jbea035/BulletFeeder/README.md

# BulletFeeder
3D printable bullet collator and feeder design.
