jbea035/BulletFeeder/Bullet Feeder Assembly.SLDASM

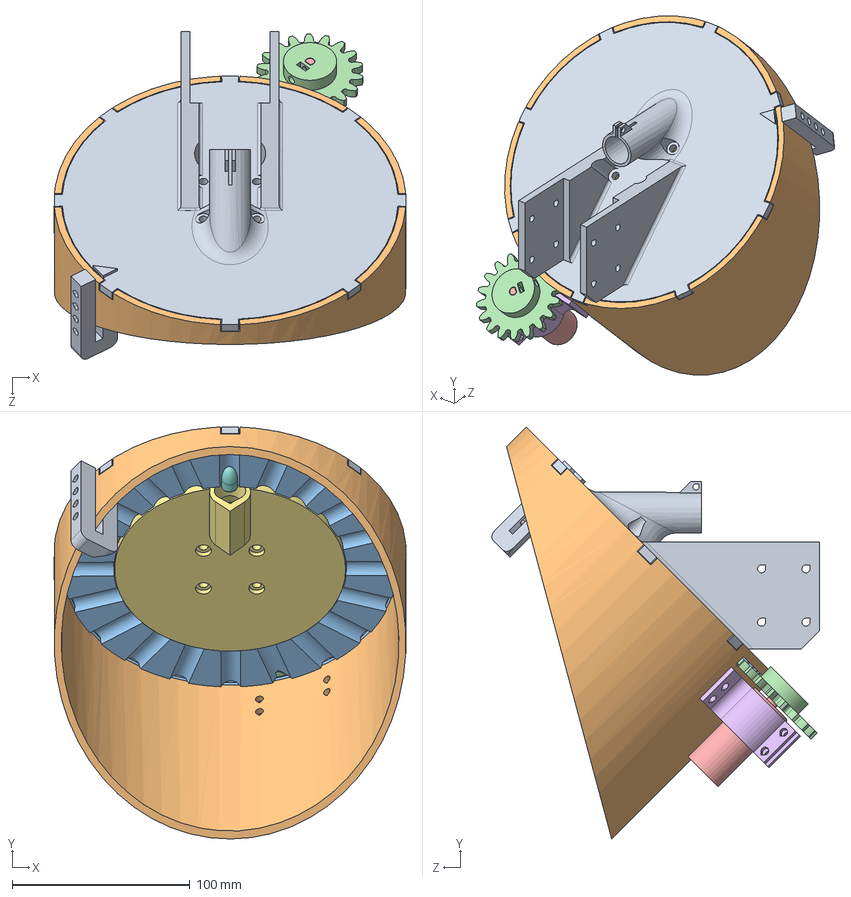
[picture p1: CAD file, 2015-07-16]
Bullet Feeder Assembly.SLDASM
197.9 x 231.8 x 184.3 mm
Bullet Feeder - Bowl Base
Bullet Feeder - Bowl
Bullet Feeder - Platter
Drive Gear
Gearhead Motor
Motor Mount
Bullet Feeder - Center - Bottom Drop
9mm Bullet
Bullet Feeder - 10mm Bullet Wiper
