jbea035/BulletFeeder/Gearhead Motor.SLDPRT

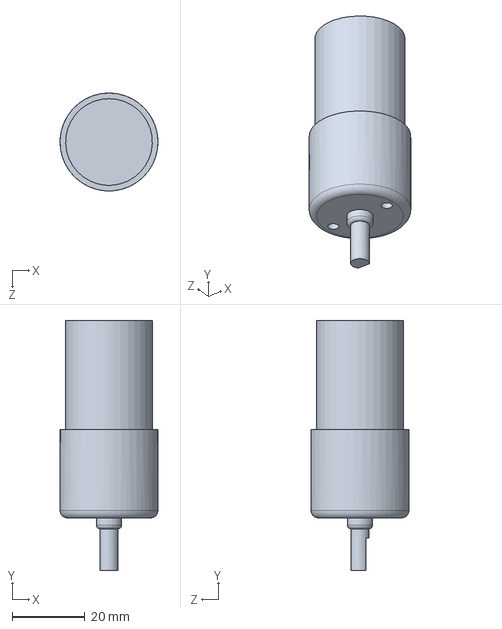
[picture p2: CAD file, 2015-07-16]
Gearhead Motor.SLDPRT
27.0 x 68.9 x 27.0 mm
