jbea035/BulletFeeder/v2 STL/Bullet Feeder - Bowl Base.STL

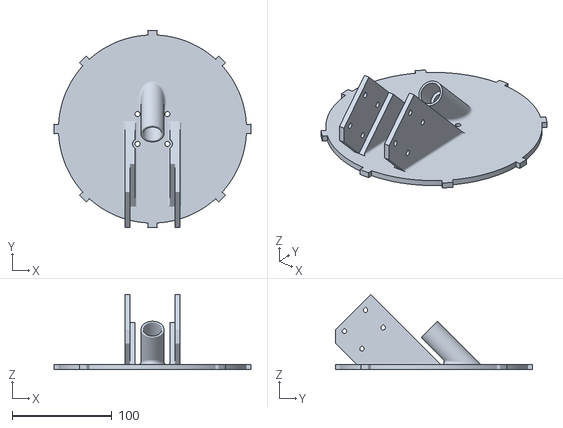
[picture p3: CAD file, 2015-07-16]
v2 STL/Bullet Feeder - Bowl Base.STL
198.0 x 198.0 x 75.7
