jbea035/BulletFeeder/Feed Die Switch Tube .SLDPRT

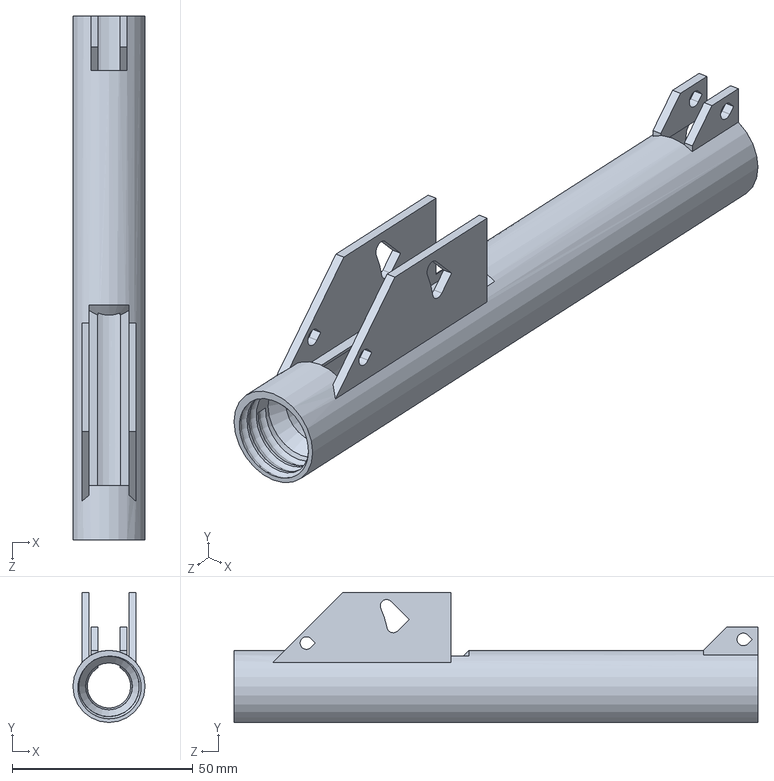
[picture p4: CAD file, 2015-07-16]
Feed Die Switch Tube .SLDPRT
20.0 x 36.0 x 145.0 mm
