jbea035/BulletFeeder/Bullet Feeder - 10mm Bullet Wiper.SLDPRT

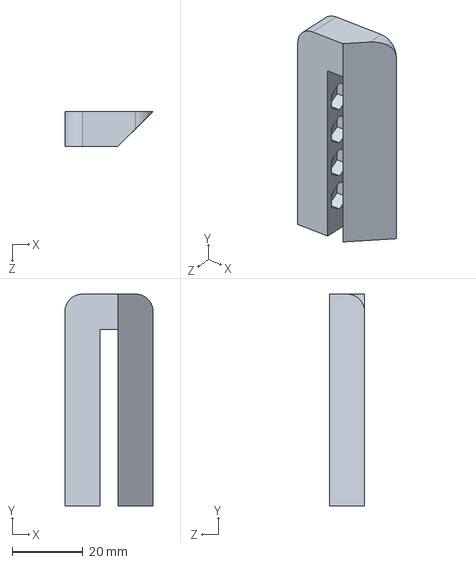
[picture p5: CAD file, 2015-07-16]
Bullet Feeder - 10mm Bullet Wiper.SLDPRT
25.0 x 60.0 x 10.0 mm
