jbea035/BulletFeeder/v2 STL/Bullet Feeder - Bowl.STL

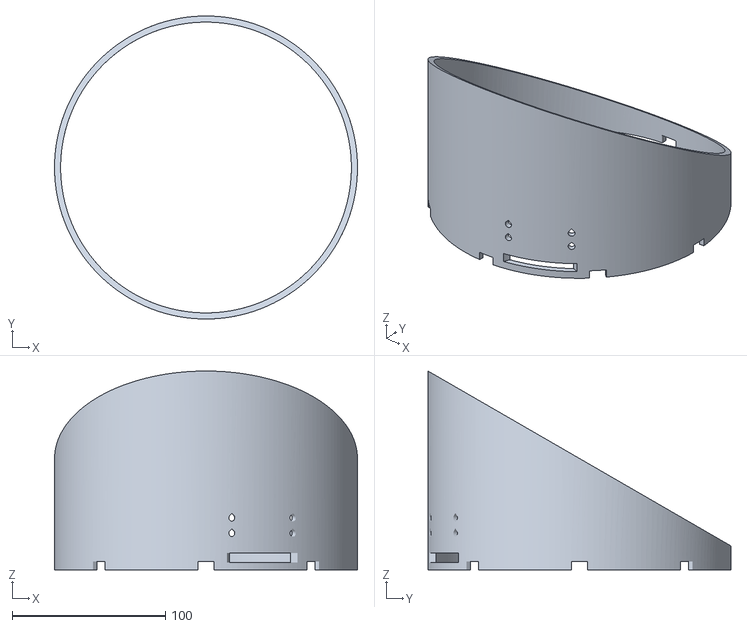
[picture p6: CAD file, 2015-07-16]
v2 STL/Bullet Feeder - Bowl.STL
198.0 x 198.0 x 130.0
