jbea035/BulletFeeder/Bullet Feeder - Platter.SLDPRT

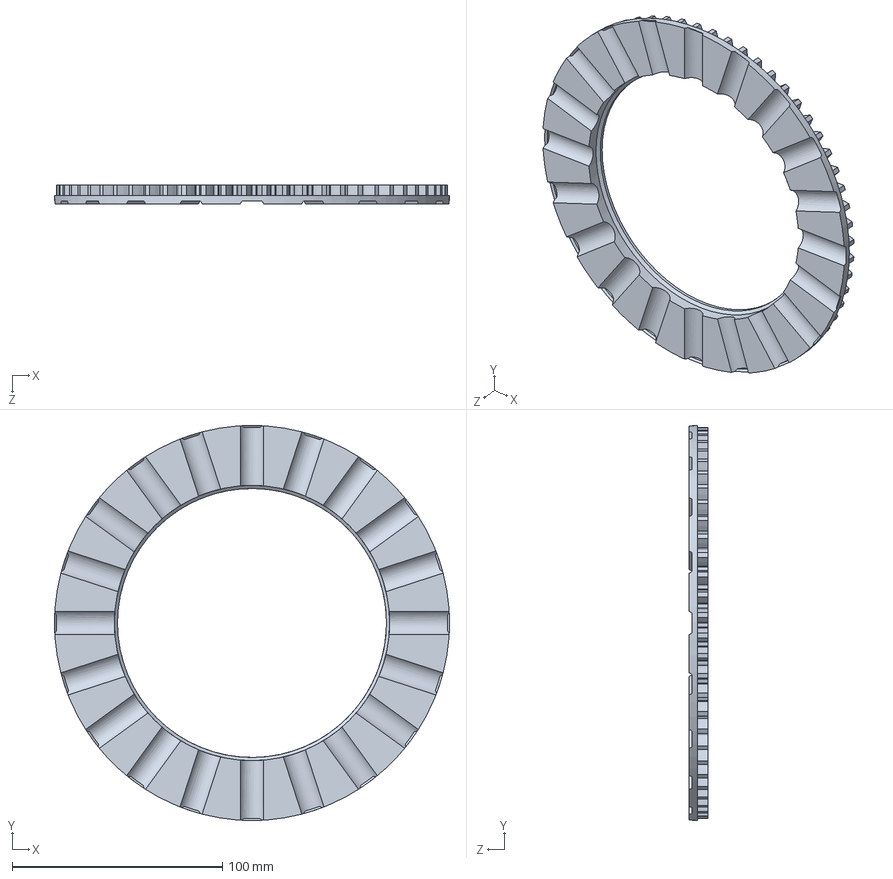
[picture p7: CAD file, 2015-07-16]
Bullet Feeder - Platter.SLDPRT
188.0 x 188.0 x 9.00 mm
