jbea035/BulletFeeder/Bullet Feeder - Center - Bottom Drop.SLDPRT

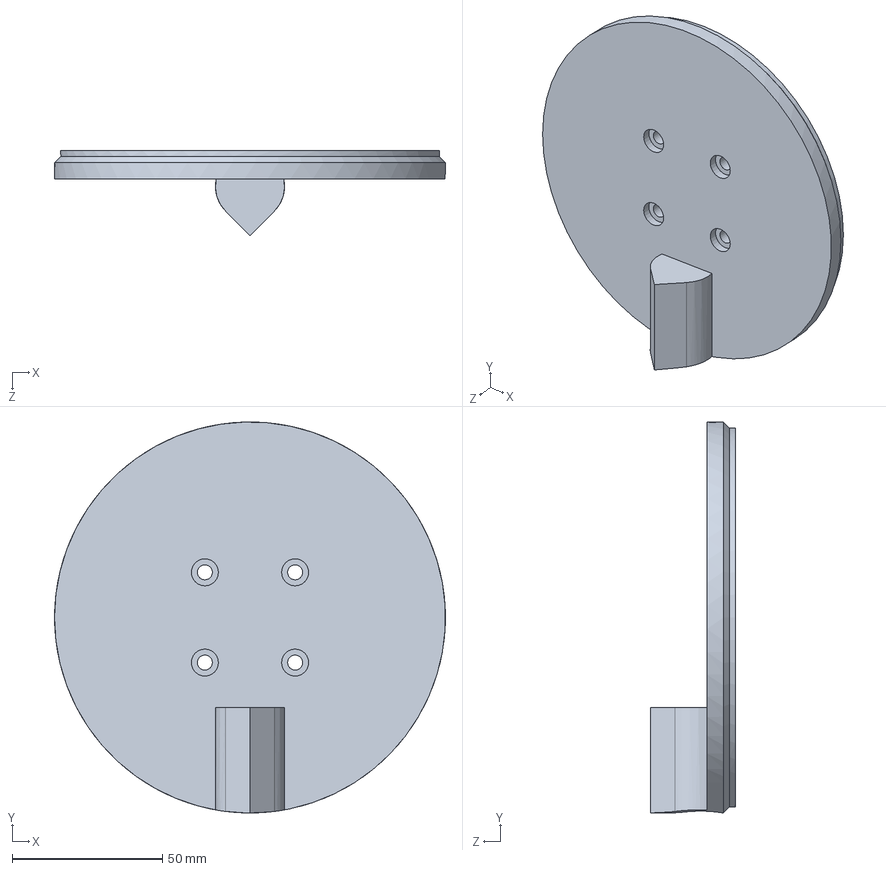
[picture p8: CAD file, 2015-07-16]
Bullet Feeder - Center - Bottom Drop.SLDPRT
130.0 x 130.0 x 28.3 mm
