jbea035/BulletFeeder/v2 STL/Drive Gear.STL

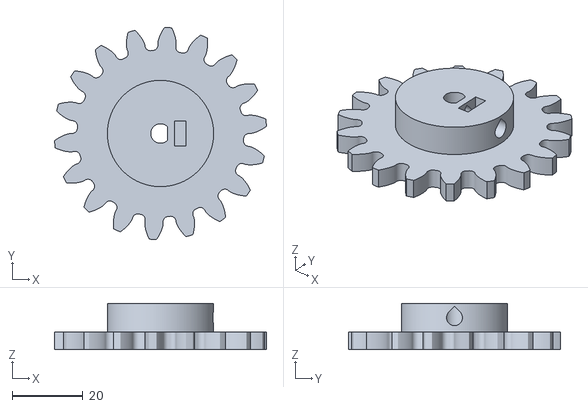
[picture p9: CAD file, 2015-07-16]
v2 STL/Drive Gear.STL
59.9 x 60.0 x 13.0
