jbea035/BulletFeeder/v2 STL/Motor Mount.STL

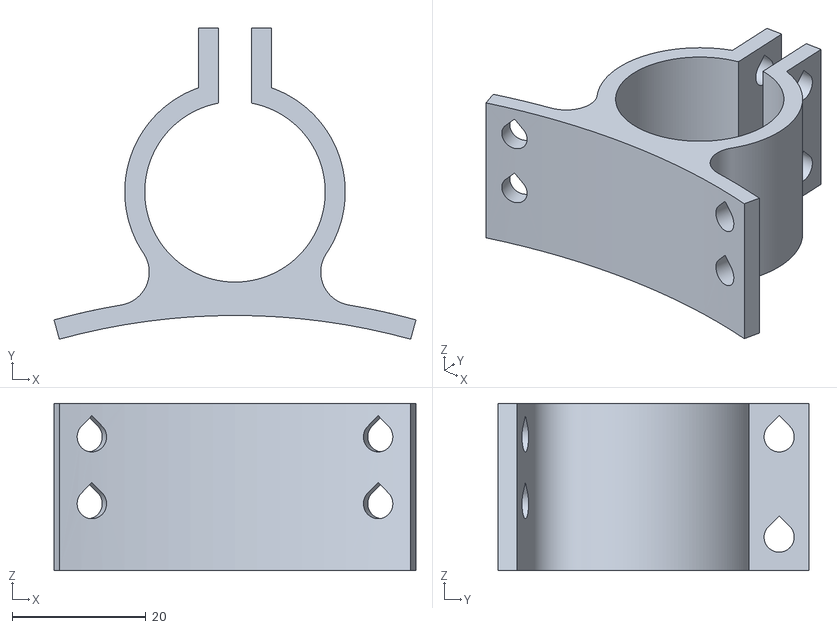
[picture p10: CAD file, 2015-07-16]
v2 STL/Motor Mount.STL
54.2 x 46.6 x 25.0
