jbea035/BulletFeeder/(list of files, cad)

Other CAD files:
v2 STL/Feed Die Switch Tube.STL
v2 STL/Bullet Feeder - 10mm Bullet Wiper.STL
Drive Gear.SLDPRT
v2 STL/Bullet Feeder - Platter.STL
Bullet Feeder - Bowl Base.SLDPRT
v2 STL/Bullet Feeder - Center - Bottom Drop.STL
Bullet Feeder - Bowl.SLDPRT
Motor Mount.SLDPRT
