jbea035/BulletFeeder/Bullet Feeder Assembly 1.JPG

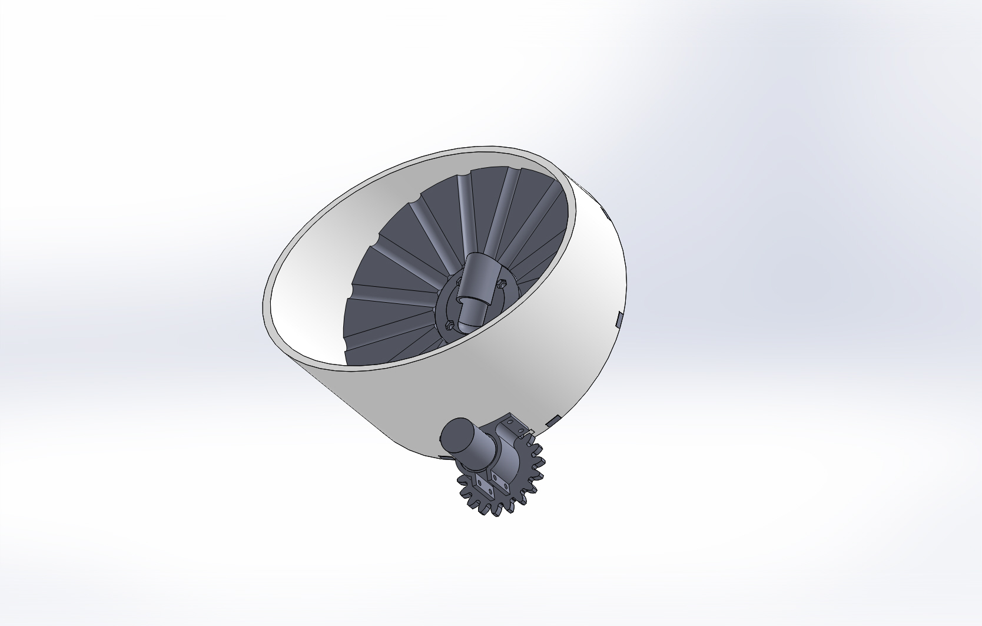
Bullet Feeder Assembly 1.JPG
