jbea035/BulletFeeder/Bullet Feeder Assembly 2.JPG

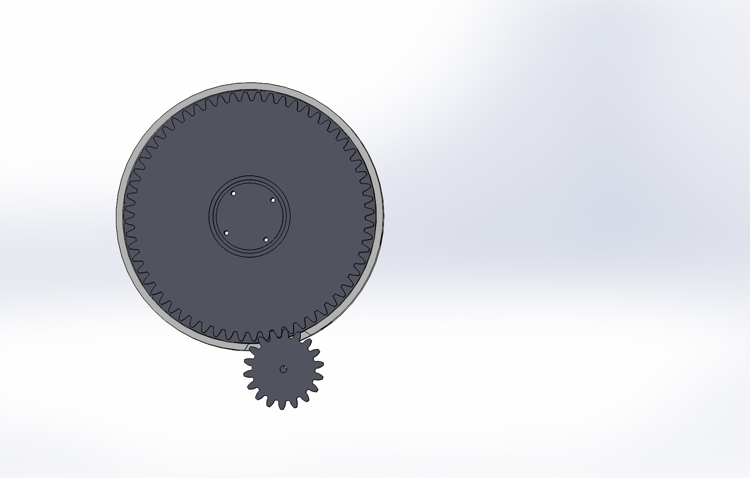
Bullet Feeder Assembly 2.JPG
