jbea035/BulletFeeder/Bullet Feeder Assembly 3.JPG

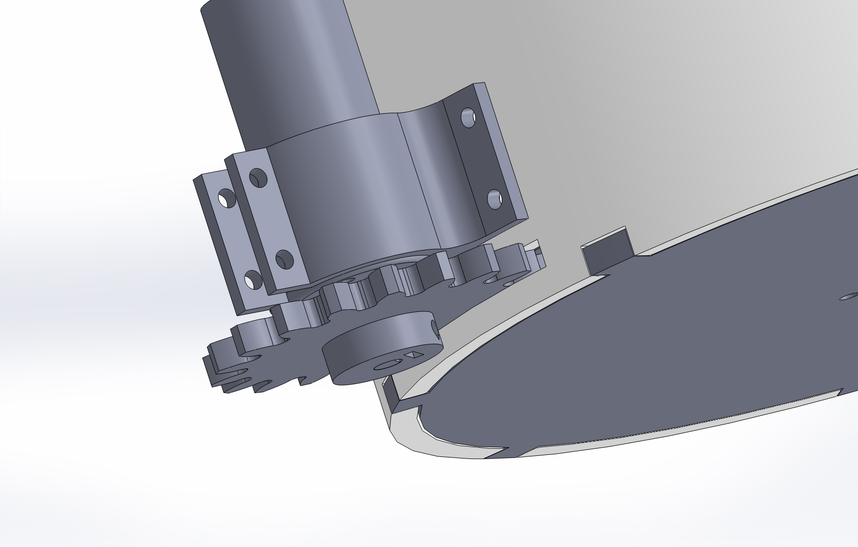
Bullet Feeder Assembly 3.JPG
