jbea035/BulletFeeder/Bullet Feeder Assembly 4.JPG

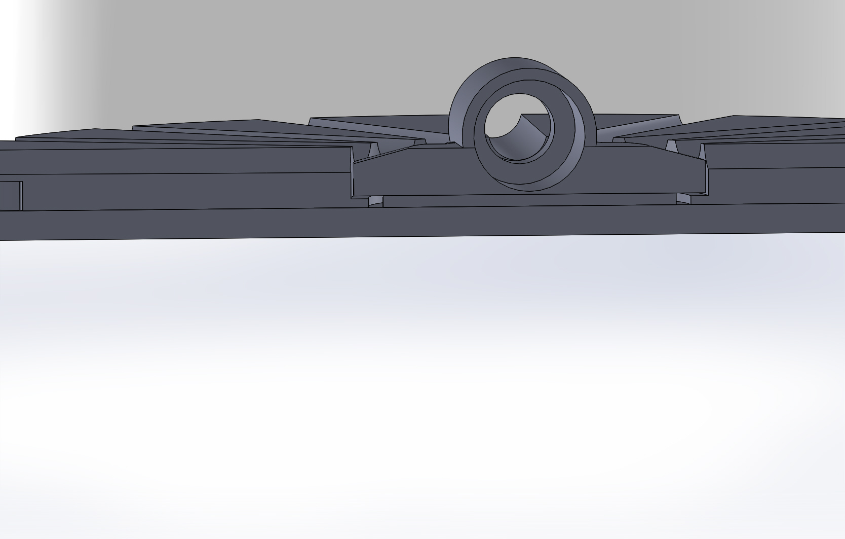
Bullet Feeder Assembly 4.JPG
