jbea035/BulletFeeder/Bullet Feeder Assembly 5.JPG

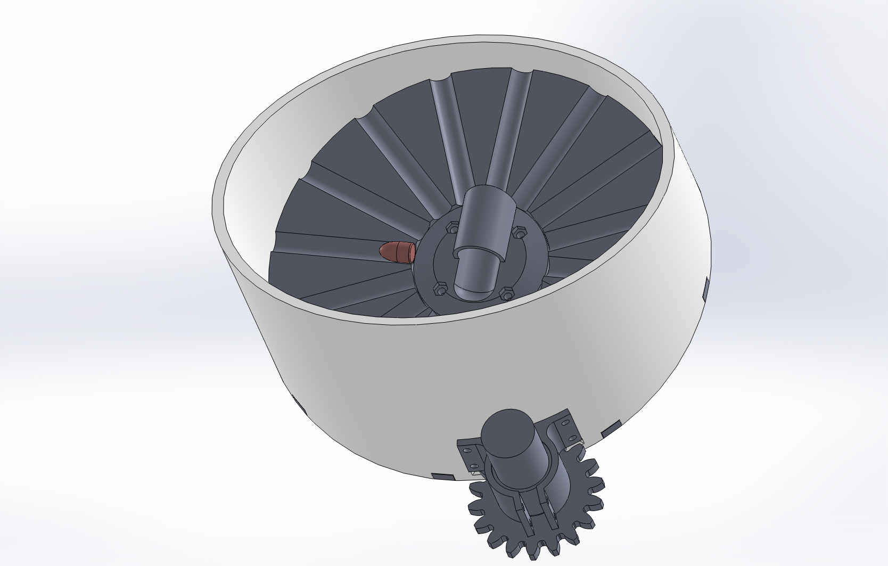
Bullet Feeder Assembly 5.JPG
