jbea035/BulletFeeder/Bullet Feeder Assembly Exploded.JPG

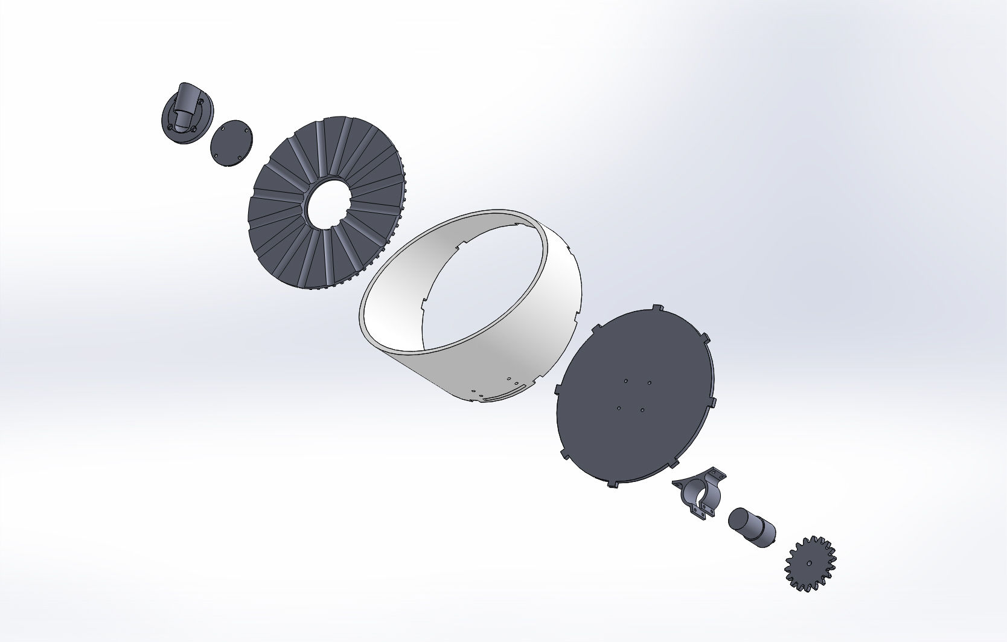
Bullet Feeder Assembly Exploded.JPG
